gavanfantom/hello-hardware/hello.pdf

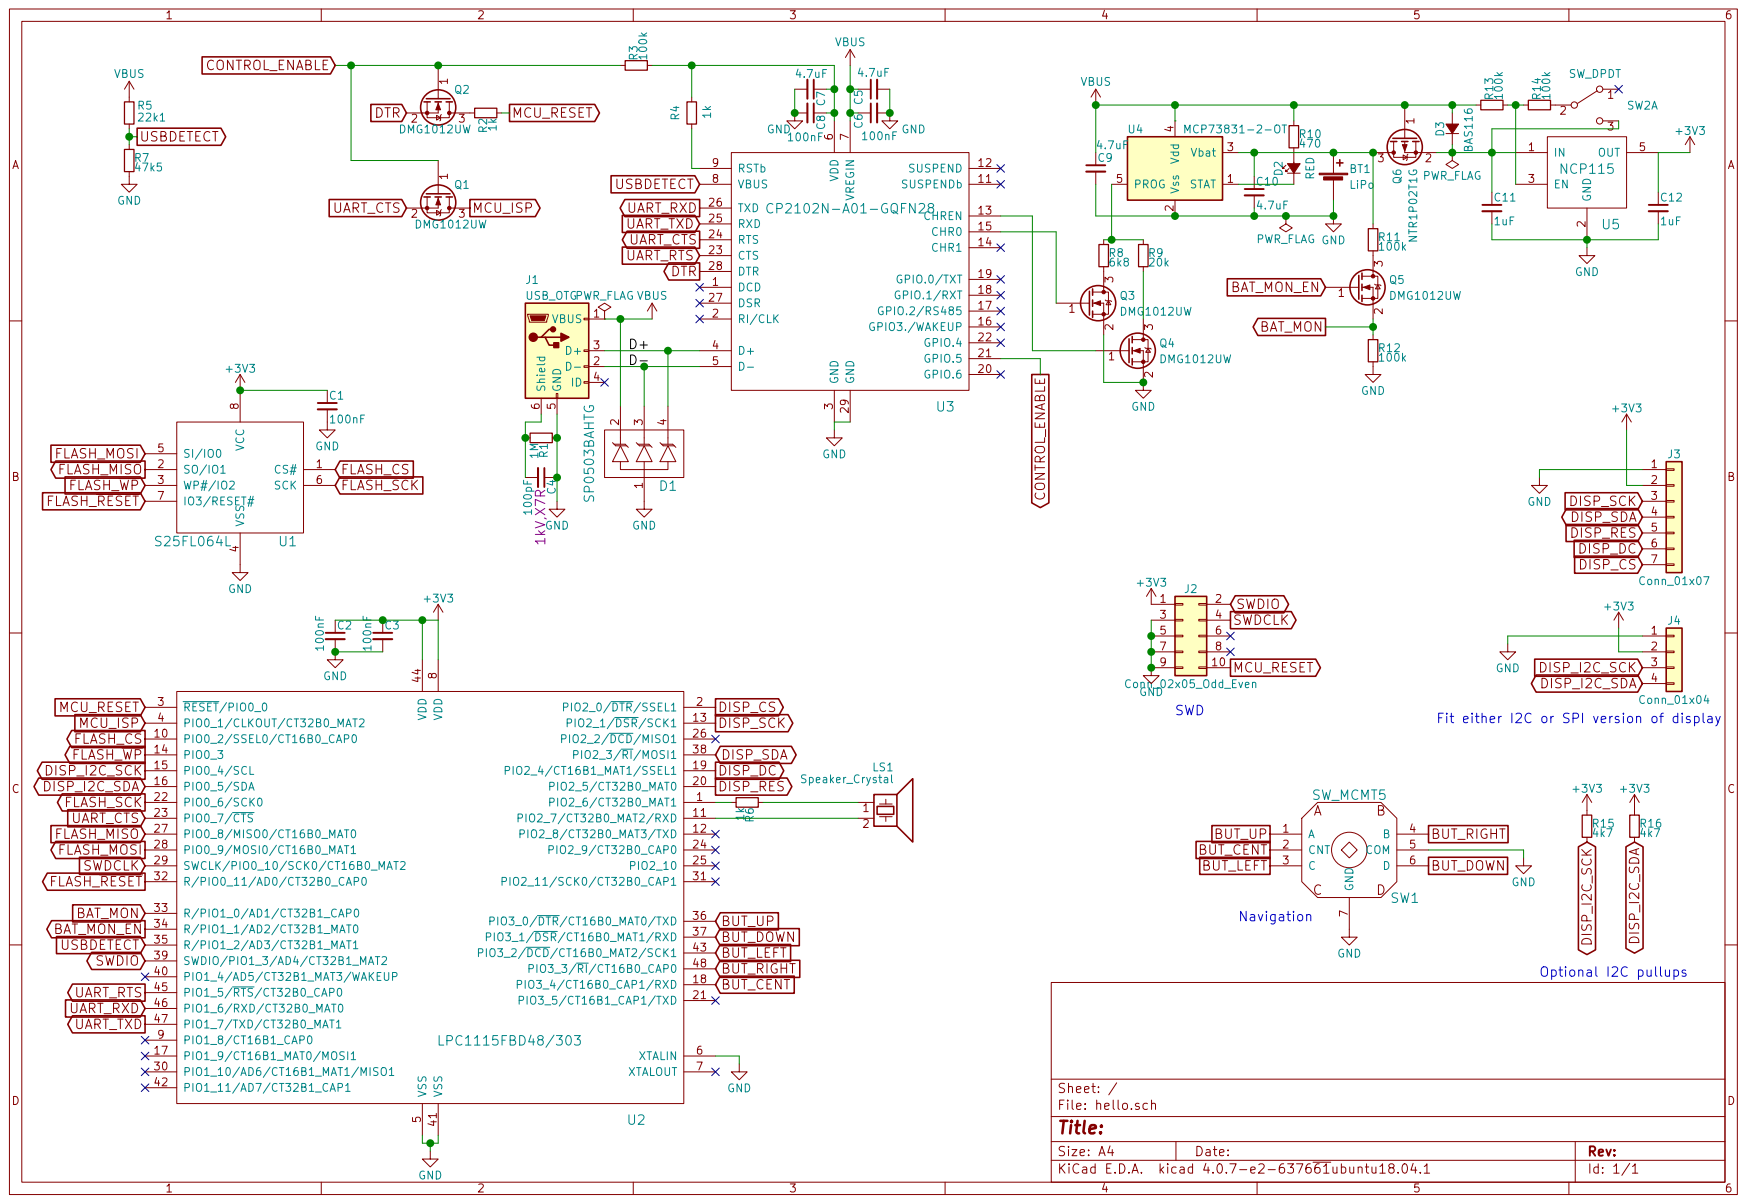
[picture p1: page 1]
