gavanfantom/hello-hardware/hello.kicad_pcb

## KiCad design hello.kicad_pcb (2019-06-25)

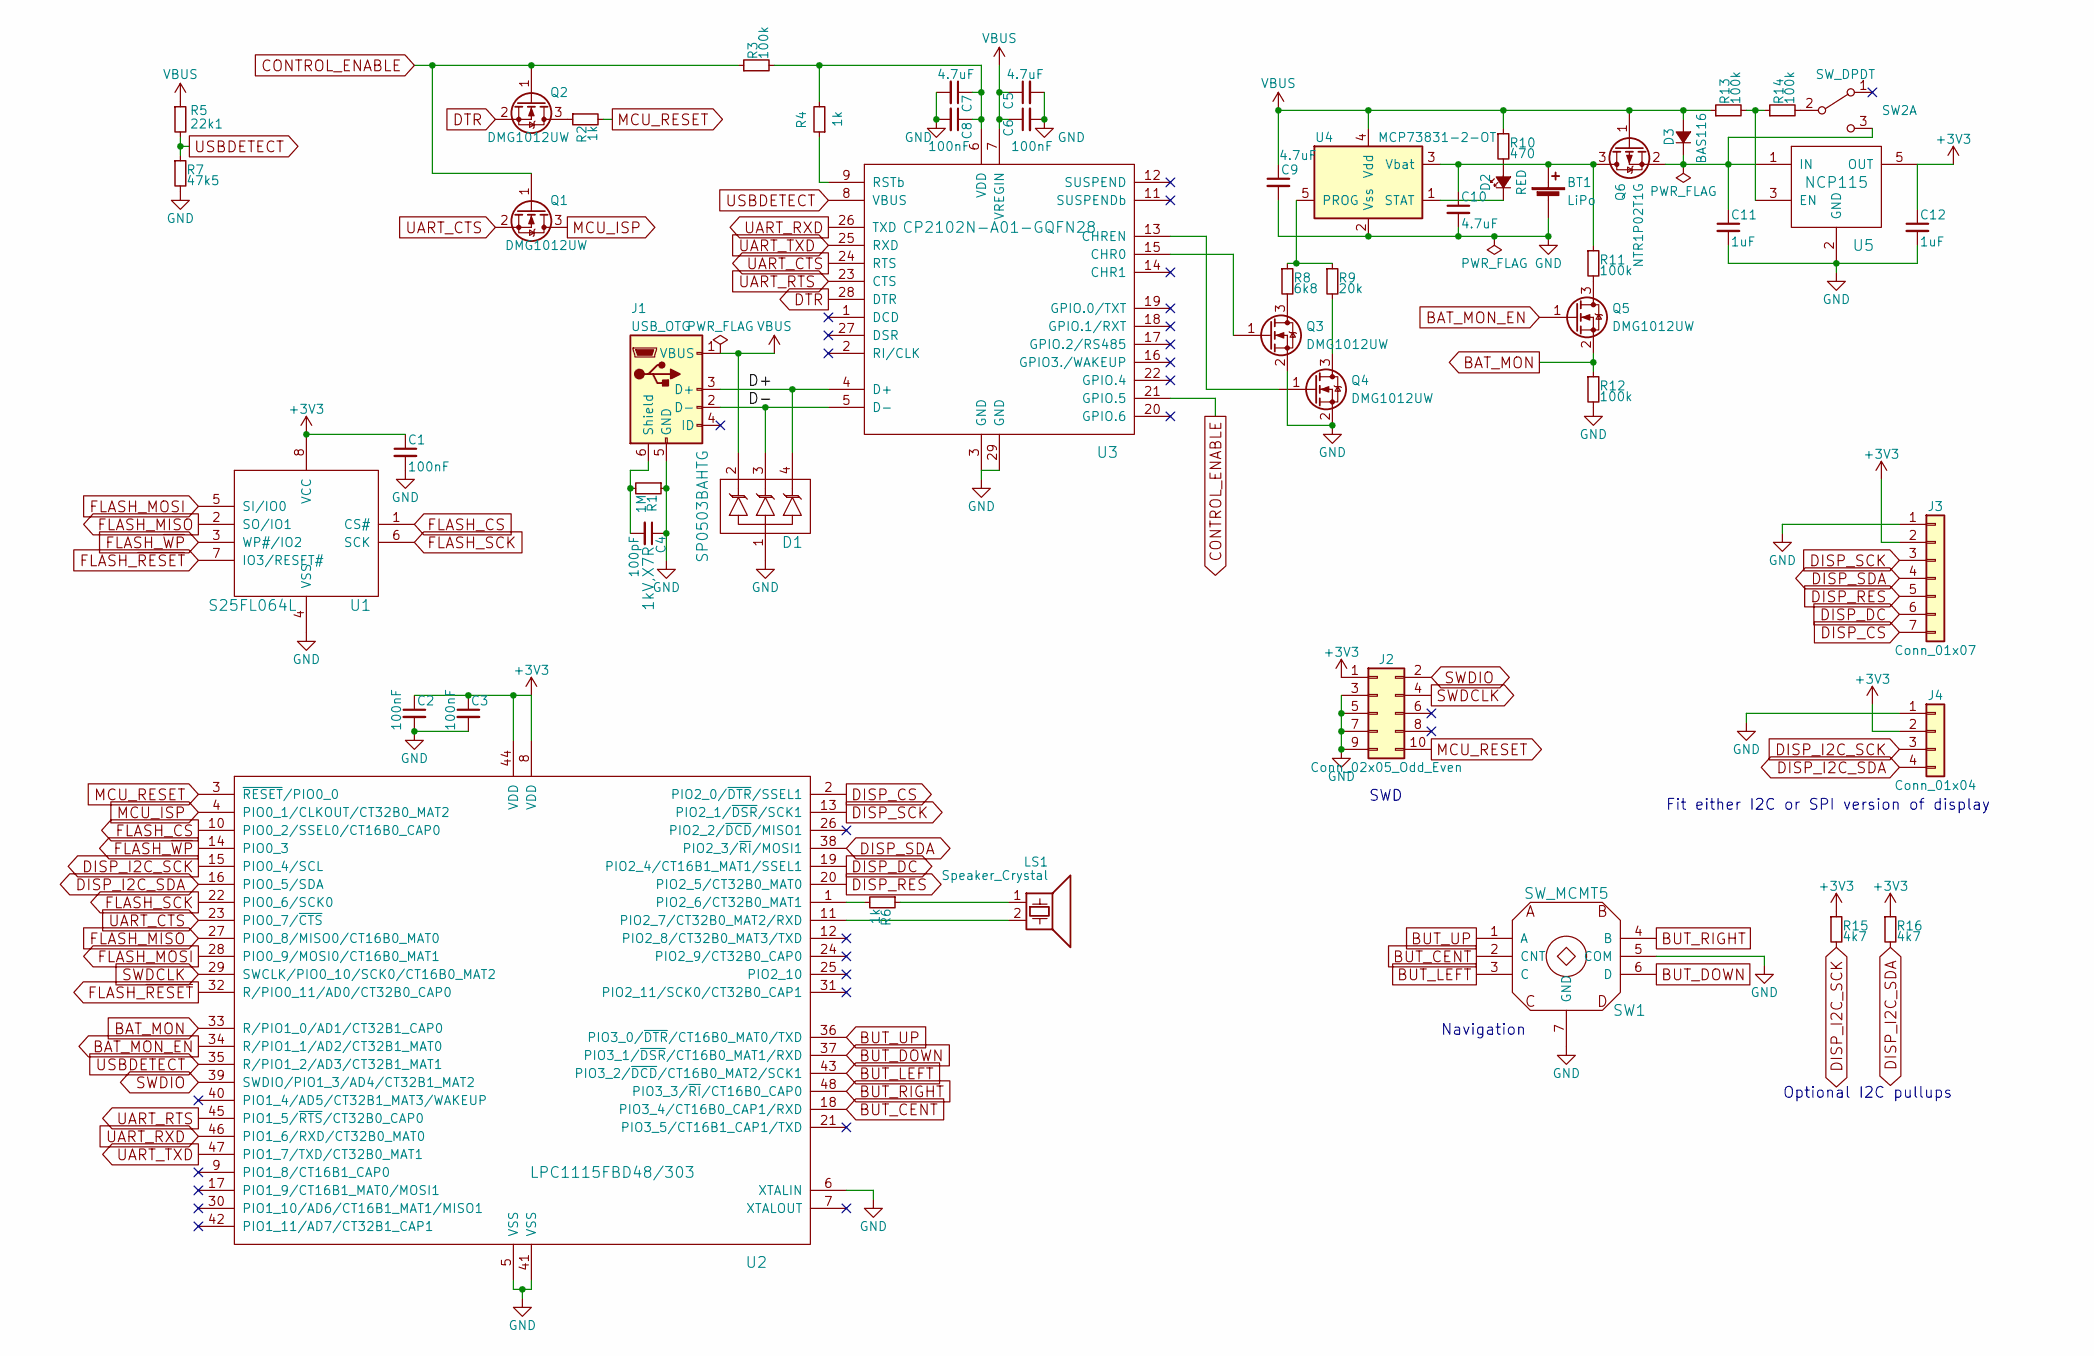
[picture p2: schematic hello.sch]

Parts:
BT1: LiPo; JST_PH_S2B-PH-SM4-TB_02x2.00mm_Angled; MPN S2B-PH-SM4-TB(LF)(SN)
C1, C2, C3, C6, C8: 100nF; C_0402; MPN MC0402B104K160CT
C4: 100pF; C_0805; MPN 885342207015
C5, C7, C9, C10: 4.7uF; C_0402; MPN AMK105BJ475MV-F
C11, C12: 1uF; C_0402; MPN GRM155R61E105KA12D
D1: SP0503BAHTG; SOT-143; MPN SP0503BAHTG
D2: RED; LED_0603; MPN KPT-1608EC
D3: BAS116; SOT-23; MPN BAS116 RF
J1: USB_OTG; USB_Micro-B_10118193-0001LF; MPN 10118193-0001LF
J2: Conn_02x05_Odd_Even; Pin_Header_Straight_2x05_Pitch1.27mm
J3: Conn_01x07; Pin_Header_Straight_1x07_Pitch2.54mm
J4: Conn_01x04; Pin_Header_Straight_1x04_Pitch2.54mm
LS1: Speaker_Crystal; PKMCS0909E4000-R1; MPN PKMCS0909E4000-R1
Q1, Q2, Q3, Q4, Q5: DMG1012UW; SOT-323_SC-70; MPN DMG1012UW
Q6: NTR1P02T1G; SOT-23; MPN NTR1P02T1G
R1: 1M; R_0603; MPN MCWR06X1004FTL
R2, R4, R6: 1k; R_0402; MPN MCWR04X1001FTL
R3, R11, R12, R13, R14: 100k; R_0402; MPN ERJ2RKF1003X
R5: 22k1; R_0402; MPN MCWR04X2212FTL
R7: 47k5; R_0402; MPN MCWR04X4752FTL
R8: 6k8; R_0402; MPN MCWR04X6801FTL
R9: 20k; R_0402; MPN MCWR04X2002FTL
R10: 470; R_0402; MPN MCWR04X4700FTL
R15, R16: 4k7; R_0402; MPN MCWR04X4701FTL
SW1: SW_MCMT5; Multicomp_MCMT5; MPN MCMT5-F-V
SW2: SW_DPDT; CK_JS202011SCQN; MPN JS202011SCQN
U1: S25FL064L; SOIJ-8_5.3x5.3mm_Pitch1.27mm; MPN S25FL064LABMFI010
U2: LPC1115FBD48/303; LQFP-48_7x7mm_Pitch0.5mm; MPN LPC1115FBD48/303
U3: CP2102N-A01-GQFN28; QFN-28-1EP_5x5mm_Pitch0.5mm; MPN CP2102N-A01-GQFN28
U4: MCP73831-2-OT; SOT-23-5; MPN MCP73831T-2ACI/OT
U5: NCP115; TSOP-5; MPN NCP115ASN330T2G

Connections:
+3V3: C1.1, C2.1, C3.1, C12.1, J2.1, J3.2, J4.2, R15.1, R16.1, U1.8 (VCC), U2.8 (VDD), U2.44 (VDD), U5.5 (OUT)
/D+: D1.4, J1.3 (D+), U3.4 (D+)
/D-: D1.3, J1.2 (D-), U3.5 (D-)
BAT_MON: Q5.2 (S), R12.1, U2.33 (R/PIO1_0/AD1/CT32B1_CAP0)
BAT_MON_EN: Q5.1 (G), U2.34 (R/PIO1_1/AD2/CT32B1_MAT0)
BUT_CENT: SW1.2 (CNT), U2.18 (PIO3_4/CT16B0_CAP1/RXD)
BUT_DOWN: SW1.6 (D), U2.37 (PIO3_1/~DSR~/CT16B0_MAT1/RXD)
BUT_LEFT: SW1.3 (C), U2.43 (PIO3_2/~DCD~/CT16B0_MAT2/SCK1)
BUT_RIGHT: SW1.4 (B), U2.48 (PIO3_3/~RI~/CT16B0_CAP0)
BUT_UP: SW1.1 (A), U2.36 (PIO3_0/~DTR~/CT16B0_MAT0/TXD)
CONTROL_ENABLE: Q1.1 (G), Q2.1 (G), R3.1, U3.21 (GPIO.5)
DISP_CS: J3.7, U2.2 (PIO2_0/~DTR~/SSEL1)
DISP_DC: J3.6, U2.19 (PIO2_4/CT16B1_MAT1/SSEL1)
DISP_I2C_SCK: J4.3, R15.2, U2.15 (PIO0_4/SCL)
DISP_I2C_SDA: J4.4, R16.2, U2.16 (PIO0_5/SDA)
DISP_RES: J3.5, U2.20 (PIO2_5/CT32B0_MAT0)
DISP_SCK: J3.3, U2.13 (PIO2_1/~DSR~/SCK1)
DISP_SDA: J3.4, U2.38 (PIO2_3/~RI~/MOSI1)
DTR: Q2.2 (S), U3.28 (DTR)
FLASH_CS: U1.1 (CS#), U2.10 (PIO0_2/SSEL0/CT16B0_CAP0)
FLASH_MISO: U1.2 (SO/IO1), U2.27 (PIO0_8/MISO0/CT16B0_MAT0)
FLASH_MOSI: U1.5 (SI/IO0), U2.28 (PIO0_9/MOSI0/CT16B0_MAT1)
FLASH_SCK: U1.6 (SCK), U2.22 (PIO0_6/SCK0)
FLASH_~RESET~: U1.7 (IO3/RESET#), U2.32 (R/PIO0_11/AD0/CT32B0_CAP0)
FLASH_~WP~: U1.3 (WP#/IO2), U2.14 (PIO0_3)
GND: BT1.2 (-), C1.2, C2.2, C3.2, C4.1, C5.2, C6.2, C7.2, C8.2, C9.2, C10.2, C11.2, C12.2, D1.1, J1.5 (GND), J2.3, J2.5, J2.7, J2.9, J3.1, J4.1, Q3.2 (S), Q4.2 (S), R1.1, R7.2, R12.2, SW1.5 (COM), SW1.7 (GND), U1.4 (VSS), U2.5 (VSS), U2.6 (XTALIN), U2.41 (VSS), U3.3 (GND), U3.29 (GND), U4.2 (Vss), U5.2 (GND)
MCU_ISP: Q1.3 (D), U2.4 (PIO0_1/CLKOUT/CT32B0_MAT2)
MCU_RESET: J2.10, R2.2, U2.3 (~RESET~/PIO0_0)
unnamed: BT1.1 (+), C10.1, Q6.3 (D), R11.1, U4.3 (Vbat)
unnamed: C4.2, J1.6 (Shield), R1.2
unnamed: C7.1, C8.1, R3.2, R4.2, U3.6 (VDD)
unnamed: C11.1, D3.3 (K), Q6.2 (S), SW2.3 (C), U5.1 (IN)
unnamed: D2.1 (K), U4.1 (STAT)
unnamed: D2.2 (A), R10.2
unnamed: LS1.1, R6.1
unnamed: LS1.2, U2.11 (PIO2_7/CT32B0_MAT2/RXD)
unnamed: Q2.3 (D), R2.1
unnamed: Q3.1 (G), U3.15 (CHR0)
unnamed: Q3.3 (D), R8.2
unnamed: Q4.1 (G), U3.13 (CHREN)
unnamed: Q4.3 (D), R9.2
unnamed: Q5.3 (D), R11.2
unnamed: R4.1, U3.9 (RSTb)
unnamed: R6.2, U2.1 (PIO2_6/CT32B0_MAT1)
unnamed: R8.1, R9.1, U4.5 (PROG)
unnamed: R13.2, R14.1, U5.3 (EN)
unnamed: R14.2, SW2.2 (B)
SWDCLK: J2.4, U2.29 (SWCLK/PIO0_10/SCK0/CT16B0_MAT2)
SWDIO: J2.2, U2.39 (SWDIO/PIO1_3/AD4/CT32B1_MAT2)
UART_CTS: Q1.2 (S), U2.23 (PIO0_7/~CTS~), U3.24 (RTS)
UART_RTS: U2.45 (PIO1_5/~RTS~/CT32B0_CAP0), U3.23 (CTS)
UART_RXD: U2.46 (PIO1_6/RXD/CT32B0_MAT0), U3.26 (TXD)
UART_TXD: U2.47 (PIO1_7/TXD/CT32B0_MAT1), U3.25 (RXD)
USBDETECT: R5.2, R7.1, U2.35 (R/PIO1_2/AD3/CT32B1_MAT1), U3.8 (VBUS)
VBUS: C5.1, C6.1, C9.1, D1.2, D3.1 (A), J1.1 (VBUS), Q6.1 (G), R5.1, R10.1, R13.1, U3.7 (VREGIN), U4.4 (Vdd)

Notes on the sheet:
Optional I2C pullups
Fit either I2C or SPI version of display
SWD
Navigation

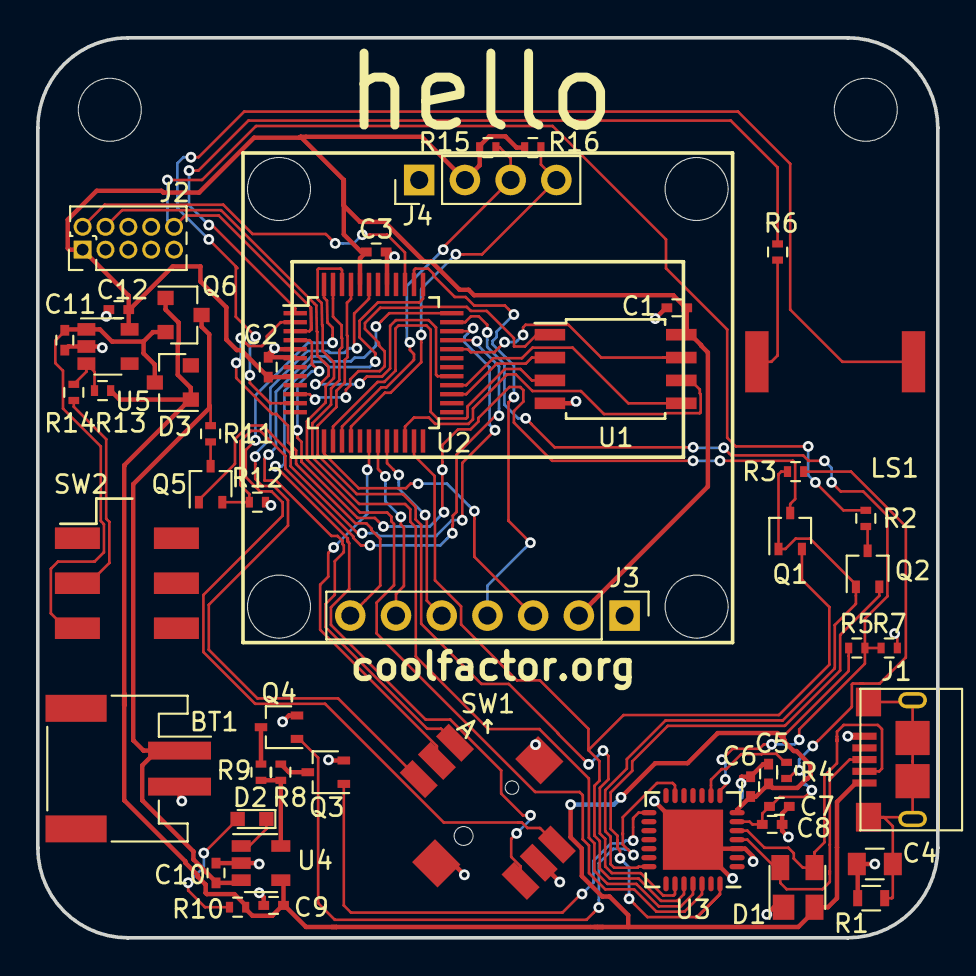
[picture p3: board hello.kicad_pcb from above]

Board: 2 copper layers, 50.0 x 50.0 mm, 50 parts (0 on the bottom side), 55 nets.
