gavanfantom/hello-hardware/(commit log)

2019-06-19 Don't ignore KiCad cache files
2019-06-19 Initial commit of hello PCB version 1
    [hello.kicad_pcb, hello.sch]
2019-06-20 The mounting holes of the USB connector are 6.6mm apart, not 7mm.
    [hello.kicad_pcb]
2019-06-25 Fix pinout for BAS116 diode (D3)
    [hello.kicad_pcb, hello.sch]
2019-06-25 Update version number to 1b
    [hello.kicad_pcb]
